Abd-El-Rhman-Saad/solar-ev-charging-station-bess/Docs/LaTeX_Source/cover.tex

\begin{titlepage}
\thispagestyle{empty}

\begin{center}
\vspace*{1.5cm}
% Logo
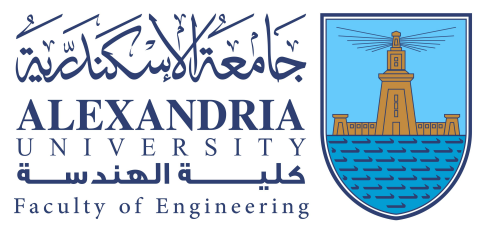
[picture p79: Docs/LaTeX_Source/Figures/logo.png]
 % غيري الاسم حسب اسم ملف اللوجو

\vspace{0.4cm}

{\small Electrical Power and Machines Department}

\vspace{0.5cm}

{\huge\bfseries Integration of Photovoltaic Systems and Energy Storage for Electric Vehicle Charging Station}

\vspace{0.3cm}

{\normalsize B.Sc. Graduation Project 2026}

\vspace{1.5cm}

{\large\textbf{Prepared by:}}

\vspace{0.3cm}

\begin{center}

\large

\renewcommand{\arraystretch}{1.4}

\begin{tabular}{c @{\hspace{2cm}} c}

\multicolumn{2}{c}{Nour El-Deen Mohamed Fathy} \\

\multicolumn{2}{c}{Abd El-Rahman Muhammad Saad} \\

\multicolumn{2}{c}{Hassan Ibrahim Hassan Al Halwani} \\

\multicolumn{2}{c}{Mai Nagah Ali} \\

\multicolumn{2}{c}{Mariam Mamdouh Ibrahim} \\

\multicolumn{2}{c}{Rewan Amr Mahmoud} \\

\multicolumn{2}{c}{Rwan Mohamed Abd-Elmokhtar} \\

\multicolumn{2}{c}{Yasmeen Salah Khobeez} \\

\multicolumn{2}{c}{Youssef Ebrahim Abd El-Sattar} \\

\end{tabular}

\end{center}

\vfill
{\Large Prof. Dr. Ahmed Abbas El Serougi}

\end{center}

\end{titlepage}
