Abd-El-Rhman-Saad/solar-ev-charging-station-bess/Docs/LaTeX_Source/List of Abbreviations.tex

\renewcommand{\arraystretch}{1.2}

\begin{longtable}{p{3cm}p{11cm}}

\textbf{Abbreviation} & \textbf{Definition} \\ \hline
\endfirsthead

\textbf{Abbreviation} & \textbf{Definition} \\ \hline
\endhead
CO2  & Carbon Dioxide \\
PV   & Photovoltaic \\
BOS  & Balance of System \\
STC  & Standard Test Conditions \\
DC   & Direct Current \\
AC   & Alternating Current \\
MPPT & Maximum Power Point Tracking \\
BESS  & Battery Energy Storage System \\
BMS  & Battery Management System \\
NiMH  & Nickel-Metal Hydride \\
Li-ion & Lithium-ion \\
EV   & Electric Vehicle \\
P\&O  & Perturb and Observe  \\
GMPPT & Global Maximum Power Point Tracking  \\
OBC  & On-Board Charger \\
PWM  & Pulse Width Modulation \\
SOC  & State of Charge \\
SPWM & Sinusoidal Pulse Width Modulation \\
THD  & Total Harmonic Distortion \\
Ir   & solar irradiance  \\
IBC  & Interleaved Boost Converter  \\
V2G  & Vehicle-to-Grid  \\
PI   & Proportional-Integral  \\
PLL  & Phase Locked Loop  \\
VSC  & Voltage Source Converter  \\
Id   & Direct current  \\
Iq   & Quadrature current  \\
BW   & BandWidth  \\
Ma   & Modulation Index  \\
CC   & Constant Current  \\
CV   & Constant Voltage  \\
PI   & Proportional-Integral  \\
PLL  & Phase Locked Loop  \\
VSC  & Voltage Source Converter  \\
Voc  & Open-Circuit Voltage  \\
Vmpp  & Voltage at Maximum Power  \\
Isc  & Short-Circuit Current  \\
Impp  & Current at Maximum Power \\
ESS  & Energy Storage System  \\
%last chapter 
DAB  & Dual Active Bridge  \\
ZVS  & Zero Voltage Switching  \\
WBG  & Wide-bandgap  \\
Si  & Silicon  \\
SiC  & Silicon Carbide  \\
GaN  & Gallium Nitride  \\
VB  & Valence Band  \\
CB  & Conduction Band  \\
AI  & Artificial Intelligence  \\
FLC  & Fuzzy Logic Control  \\
ANNs  & Artificial Neural Networks  \\
RL  & Reinforcement Learning  \\
EMS  & Energy Management System  \\
IoT  & Internet of Things  \\
ESS & Energy storage system \\
D & duty cycle  \\
$f_{s}$  & switching frequency  \\
$\Delta i_{l}$ & current ripples \\
% --- Added from Hardware Implementation (Section 6.2) ---
CCM & Continuous Conduction Mode \\
ESR & Equivalent Series Resistance \\
MCU & Microcontroller Unit \\
ADC & Analog-to-Digital Converter \\
ISR & Interrupt Service Routine \\
DSO & Digital Storage Oscilloscope \\
$R_{DS(on)}$ & On-State Drain-to-Source Resistance \\
$V_{DS}$ & Drain-to-Source Breakdown Voltage \\
$C_{iss}$ & Input Capacitance \\
$Q_{gd}$ & Gate-to-Drain Miller Charge \\
$T_J$ & Junction Temperature \\
$T_C$ & Case Temperature \\
CTR & Current Transfer Ratio \\
OVP & Over-Voltage Protection \\
UVP & Under-Voltage Protection \\
OCP & Over-Current Protection \\
UVLO & Under-Voltage Lockout \\
SGND & Signal Ground \\
PGND & Power Ground \\
\end{longtable}
