Abd-El-Rhman-Saad/solar-ev-charging-station-bess/Docs/LaTeX_Source/references.tex

\renewcommand{\bibname}{References}

\begin{thebibliography}{99}

\bibitem{masters2013}
G. M. Masters,
\textit{Renewable and Efficient Electric Power Systems},
2nd ed., John Wiley \& Sons, 2013.

\bibitem{dunn2011}
B. Dunn, H. Kamath, and J. M. Tarascon,
"Electrical Energy Storage for the Grid: A Battery of Choices,"
\textit{Science},
vol. 334, no. 6058, pp. 928--935, 2011.

\bibitem{tie2013}
S. F. Tie and C. W. Tan,
"A Review of Energy Sources and Energy Management System in Electric Vehicles,"
\textit{Renewable and Sustainable Energy Reviews},
vol. 20, pp. 82--102, 2013.

\bibitem{mohan2003} N. Mohan, T. M. Undeland, and W. P. Robbins, \textit{Power Electronics: Converters, Applications, and Design}, 3rd ed., John Wiley \& Sons, 2003.

\bibitem{singh2020} A. K. Singh, et al., ``Solar PV and Grid Based Isolated AC/DC Microgrid for Electric Vehicle Charging Station,'' \textit{IEEE Transactions on Industry Applications}, 2020.

\bibitem{emadi2015}
A. Emadi,
\textit{Advanced Electric Drive Vehicles},
CRC Press, 2015.

\bibitem{iea2024}
International Energy Agency (IEA),
\textit{Global EV Outlook 2024},
Paris, France, 2024.

\bibitem{baliga2008}
B. J. Baliga,
\textit{Fundamentals of Power Semiconductor Devices},
Springer, 2008.

\bibitem{wolfspeed}
Wolfspeed,
\textit{Silicon Carbide Technology Overview},
Technical Report.

\bibitem{rehmani2018}
M. H. Rehmani, M. Reisslein, A. Rachedi, M. Erol-Kantarci, and M. Radenkovic,
"Integrating Renewable Energy Resources into the Smart Grid: Recent Developments in Information and Communication Technologies,"
\textit{IEEE Transactions on Industrial Informatics},
2018.

\bibitem{faraj2020}
Faraj, K. S., \& Farhood, J. (2020). Analysis and Comparison of DC-DC Boost Converter and Interleaved DC-DC Boost Converter. \textit{International Journal of Engineering and Technology}, 622--635.

\end{thebibliography}
