Abd-El-Rhman-Saad/solar-ev-charging-station-bess/1_PV_Modeling_and_MPPT/images/forced_mppt_logic2.png

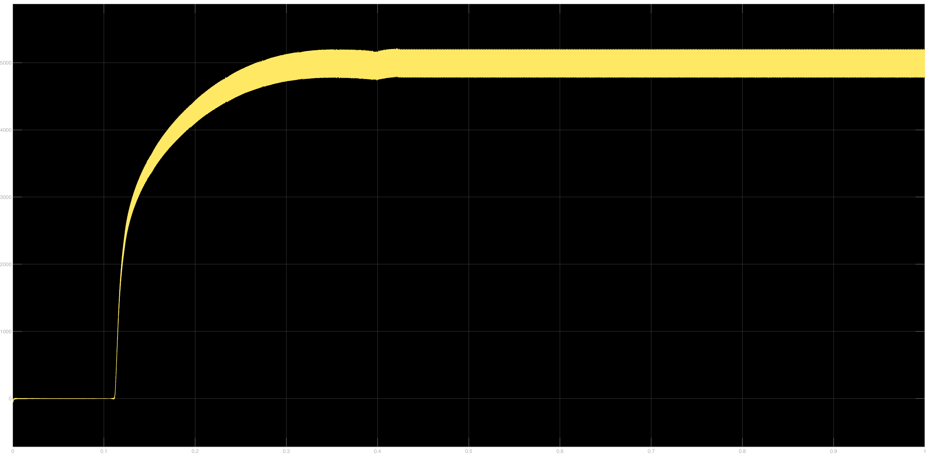
1_PV_Modeling_and_MPPT/images/forced_mppt_logic2.png
