Abd-El-Rhman-Saad/solar-ev-charging-station-bess/1_PV_Modeling_and_MPPT/images/mppt_logic.png

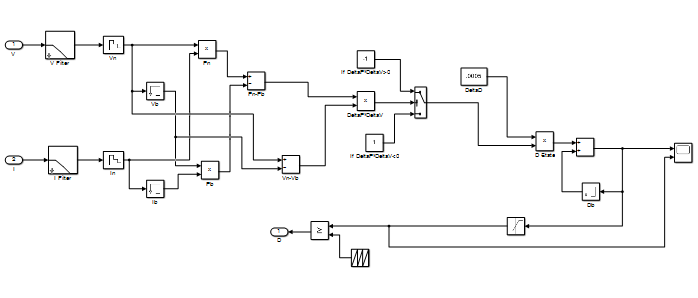
1_PV_Modeling_and_MPPT/images/mppt_logic.png
