Abd-El-Rhman-Saad/solar-ev-charging-station-bess/2_Interleaved_Boost_Converter/images/interleaved_system_model.png

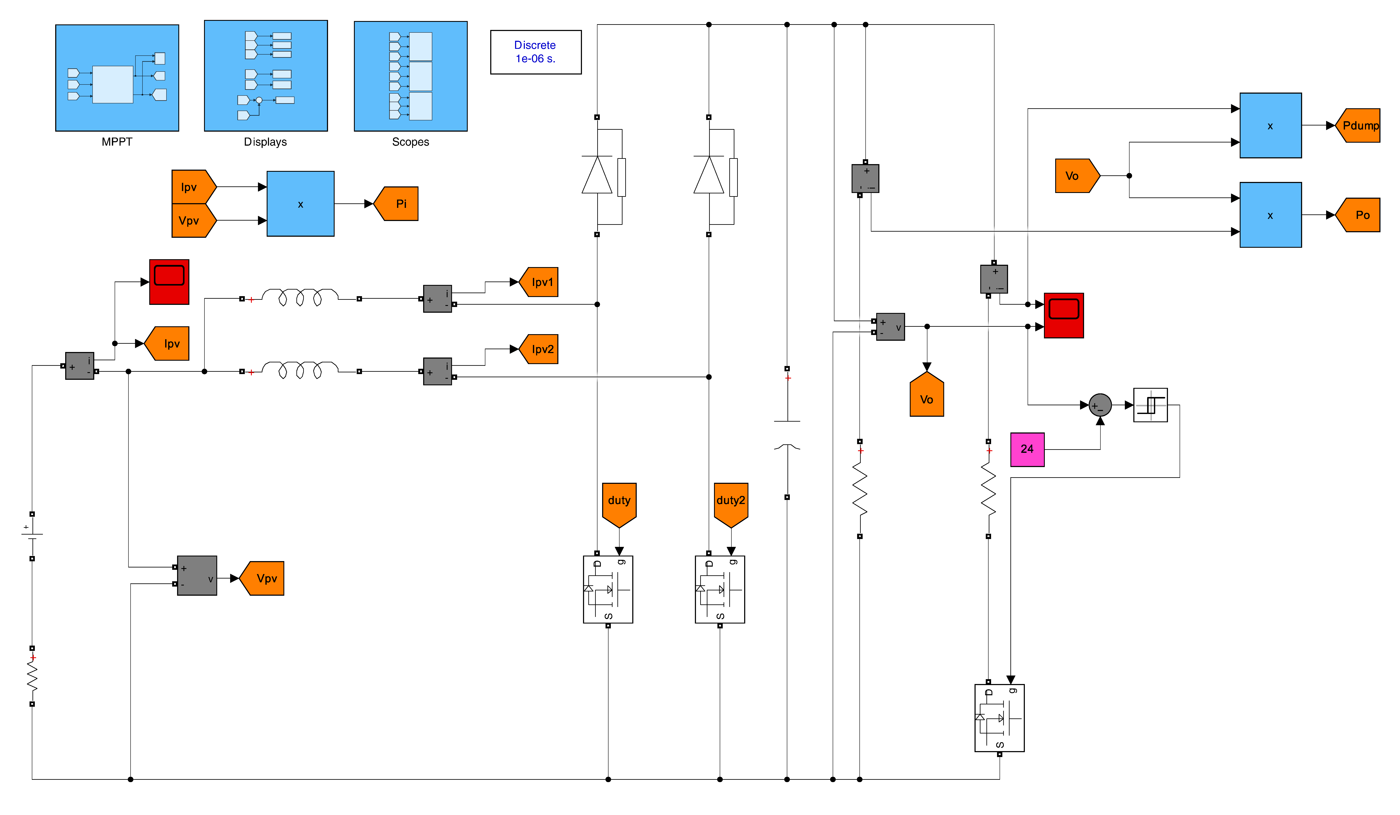
2_Interleaved_Boost_Converter/images/interleaved_system_model.png
