Abd-El-Rhman-Saad/solar-ev-charging-station-bess/2_Interleaved_Boost_Converter/images/ripple_cancellation.png

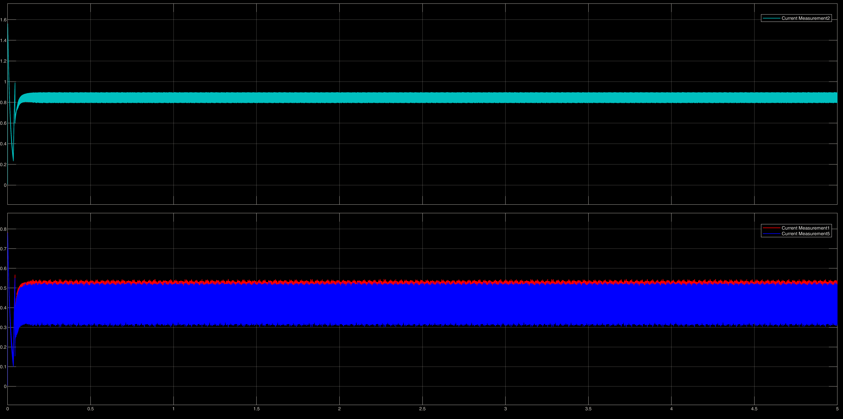
2_Interleaved_Boost_Converter/images/ripple_cancellation.png
