Abd-El-Rhman-Saad/solar-ev-charging-station-bess/3_BESS_and_2Q_Chopper/images/2q_chopper_model.png

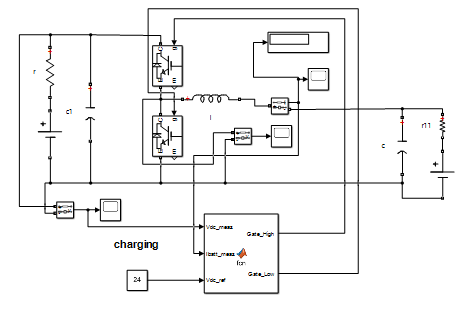
3_BESS_and_2Q_Chopper/images/2q_chopper_model.png
