Abd-El-Rhman-Saad/solar-ev-charging-station-bess/3_BESS_and_2Q_Chopper/images/chopper_control_code.png

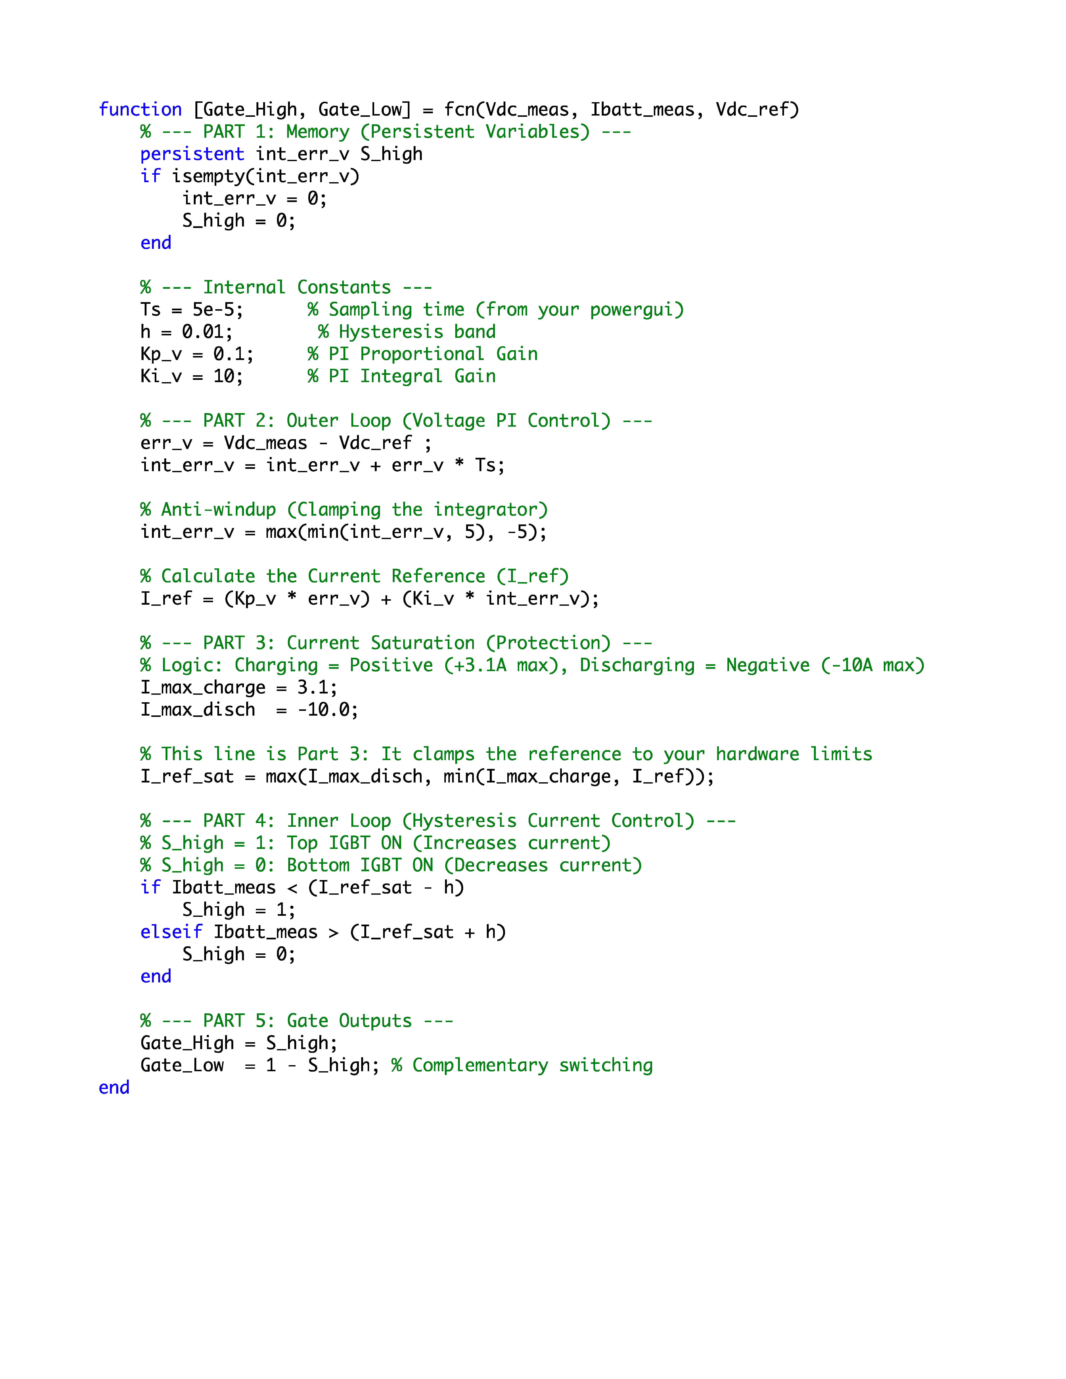
3_BESS_and_2Q_Chopper/images/chopper_control_code.png
