Abd-El-Rhman-Saad/solar-ev-charging-station-bess/4_EV_Buck_Charger/images/Buck_CCCV_Scope_2.png

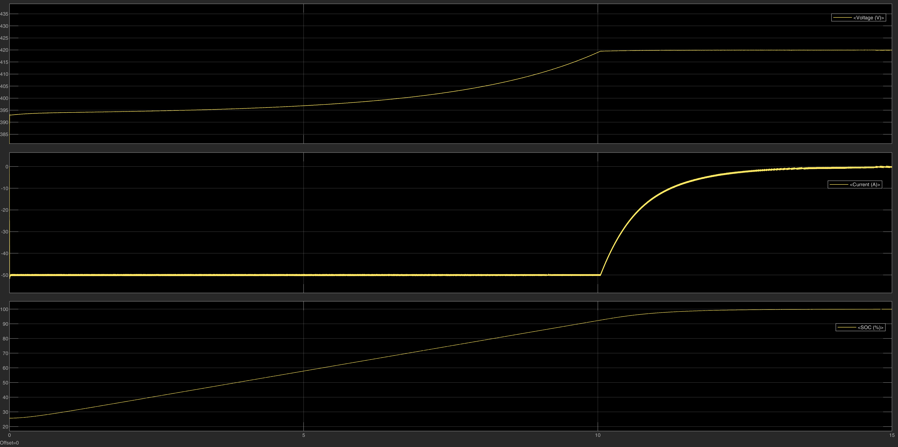
4_EV_Buck_Charger/images/Buck_CCCV_Scope_2.png
