Abd-El-Rhman-Saad/solar-ev-charging-station-bess/4_EV_Buck_Charger/images/PWM_Generator_Zoomed.jpg

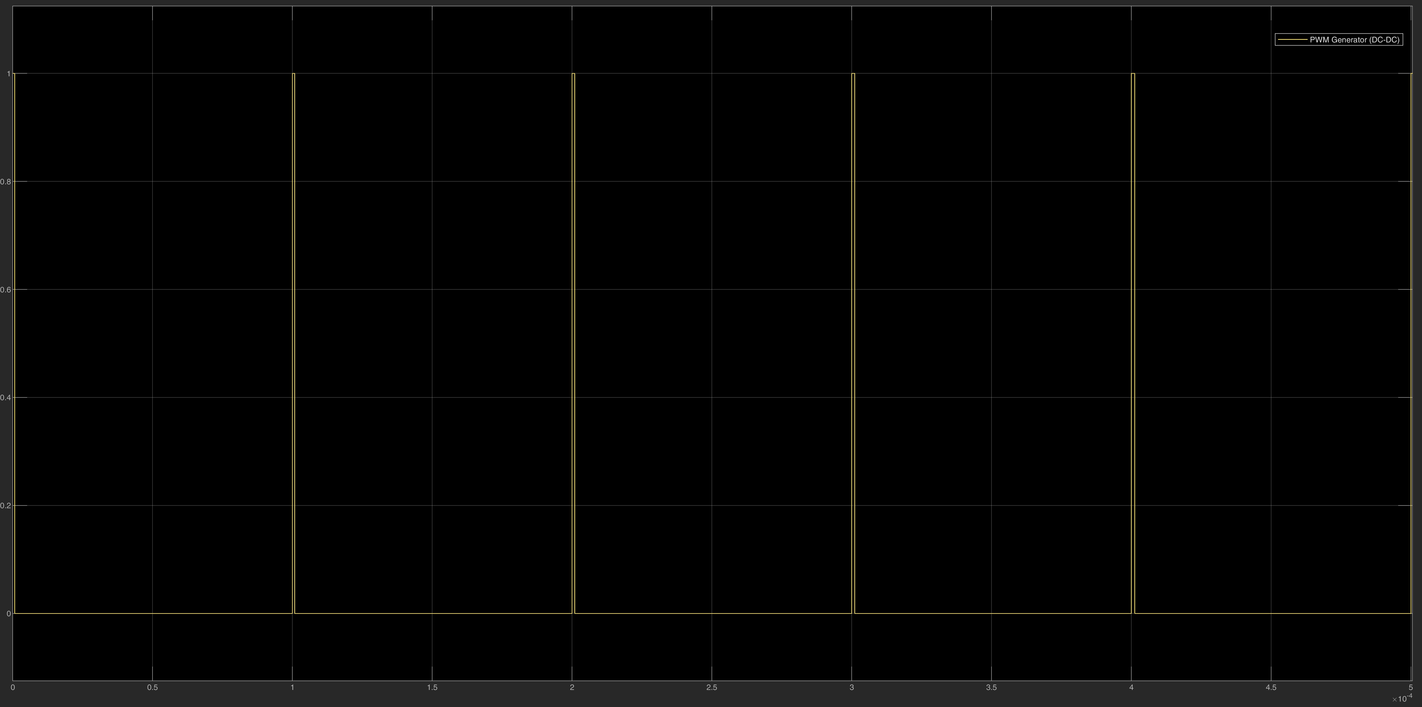
4_EV_Buck_Charger/images/PWM_Generator_Zoomed.jpg
