Abd-El-Rhman-Saad/solar-ev-charging-station-bess/Docs/LaTeX_Source/Figures/1.systeam software.jpeg

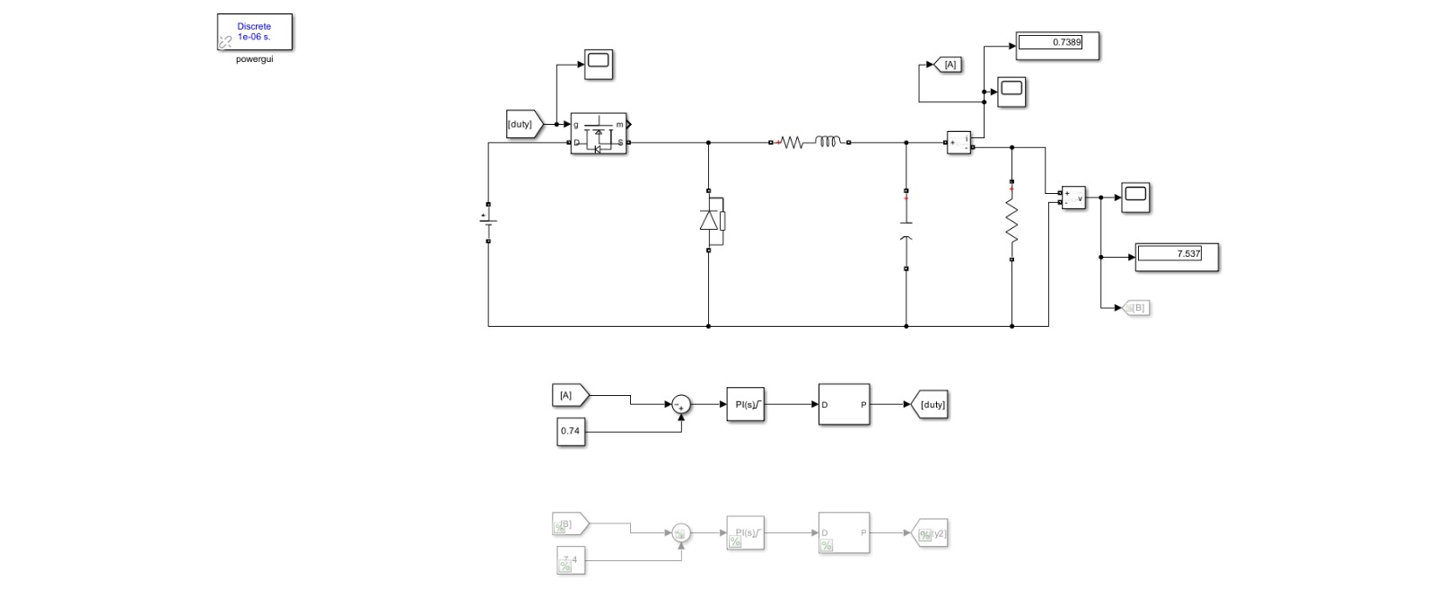
Docs/LaTeX_Source/Figures/1.systeam software.jpeg
