Abd-El-Rhman-Saad/solar-ev-charging-station-bess/Docs/LaTeX_Source/Figures/2.image.jpg

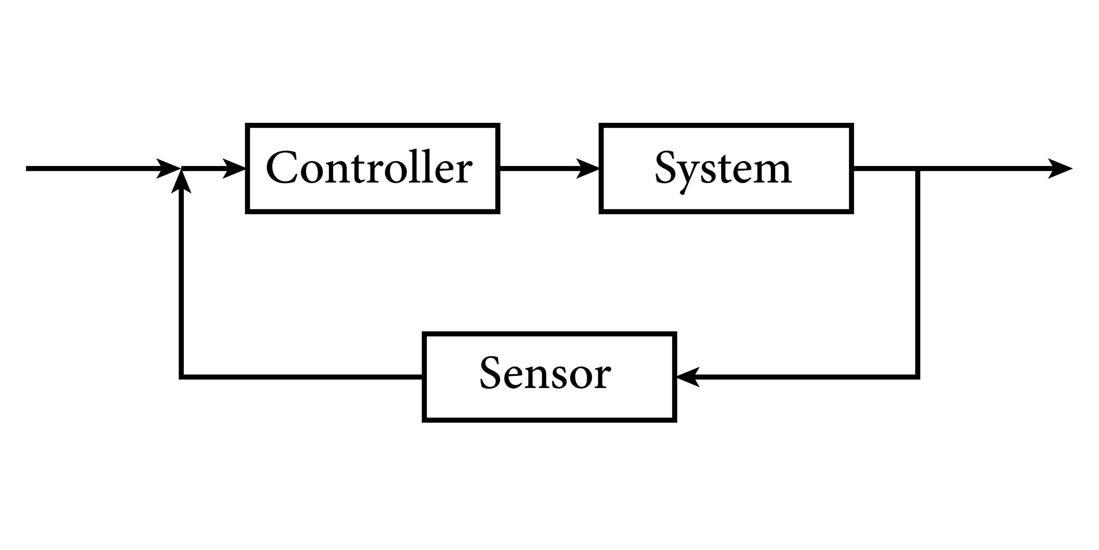
Docs/LaTeX_Source/Figures/2.image.jpg
