Abd-El-Rhman-Saad/solar-ev-charging-station-bess/Docs/LaTeX_Source/Figures/3.pid.png

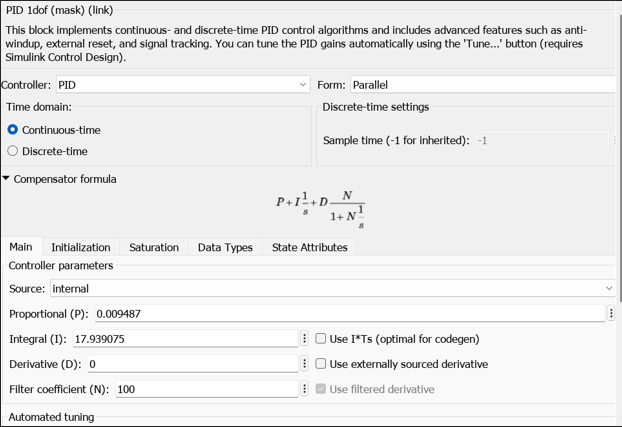
Docs/LaTeX_Source/Figures/3.pid.png
