Abd-El-Rhman-Saad/solar-ev-charging-station-bess/Docs/LaTeX_Source/Figures/4.0.5a OPEN LOOP.png

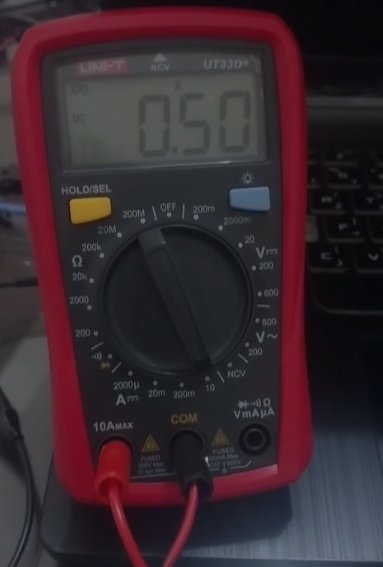
Docs/LaTeX_Source/Figures/4.0.5a OPEN LOOP.png
