Abd-El-Rhman-Saad/solar-ev-charging-station-bess/Docs/LaTeX_Source/Figures/5.Iref1=0.3A.jpeg

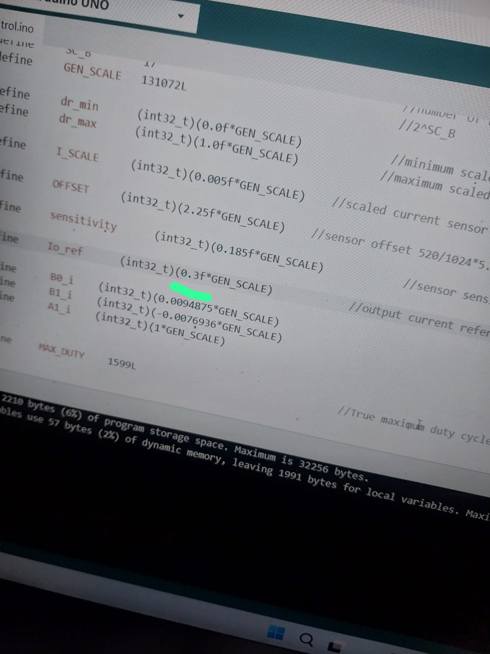
Docs/LaTeX_Source/Figures/5.Iref1=0.3A.jpeg
