Abd-El-Rhman-Saad/solar-ev-charging-station-bess/Docs/LaTeX_Source/Figures/6.3.6 3.7V.jpeg

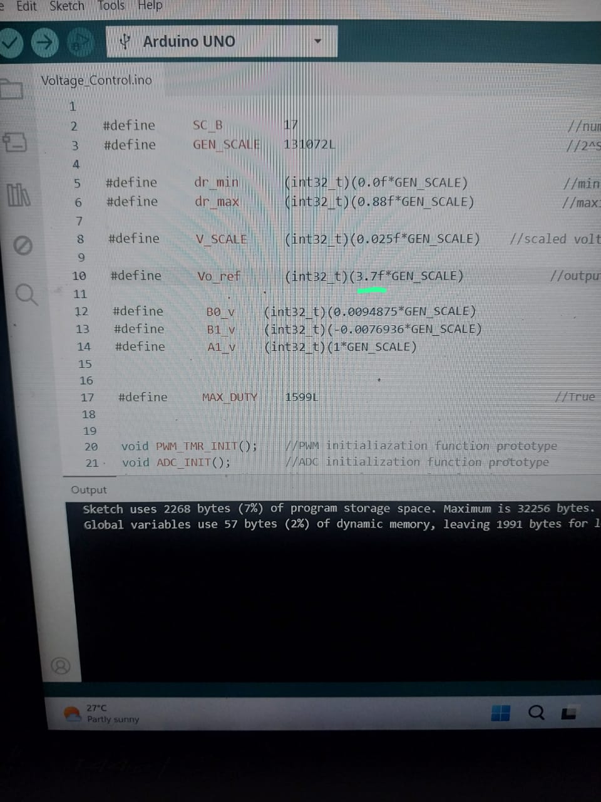
Docs/LaTeX_Source/Figures/6.3.6 3.7V.jpeg
