Abd-El-Rhman-Saad/solar-ev-charging-station-bess/Docs/LaTeX_Source/Figures/6.Iref2= 0.5A.jpeg

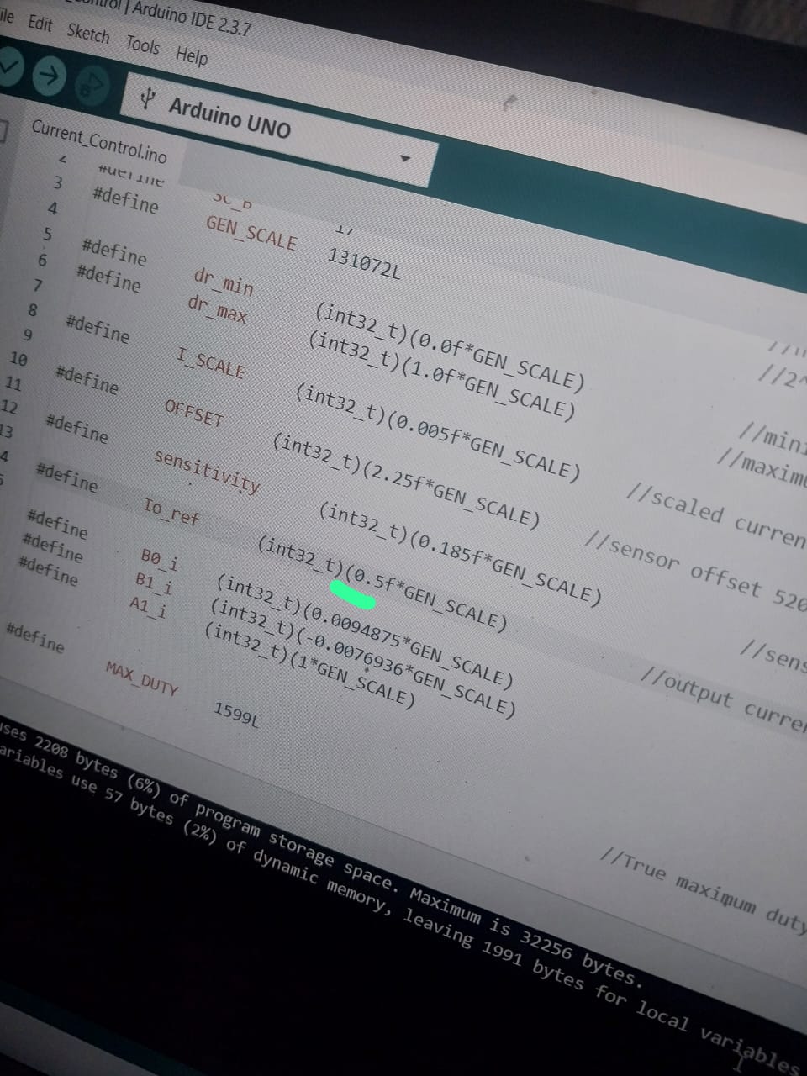
Docs/LaTeX_Source/Figures/6.Iref2= 0.5A.jpeg
