Abd-El-Rhman-Saad/solar-ev-charging-station-bess/Docs/LaTeX_Source/Figures/7.Iref3 = 0.4A.jpeg

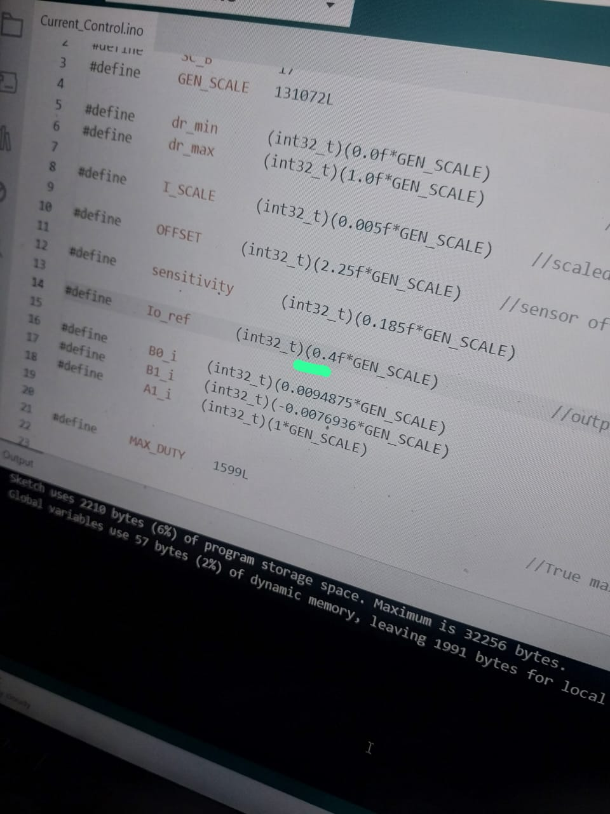
Docs/LaTeX_Source/Figures/7.Iref3 = 0.4A.jpeg
