Abd-El-Rhman-Saad/solar-ev-charging-station-bess/Docs/LaTeX_Source/Figures/8.Iref= 0.6A.jpeg

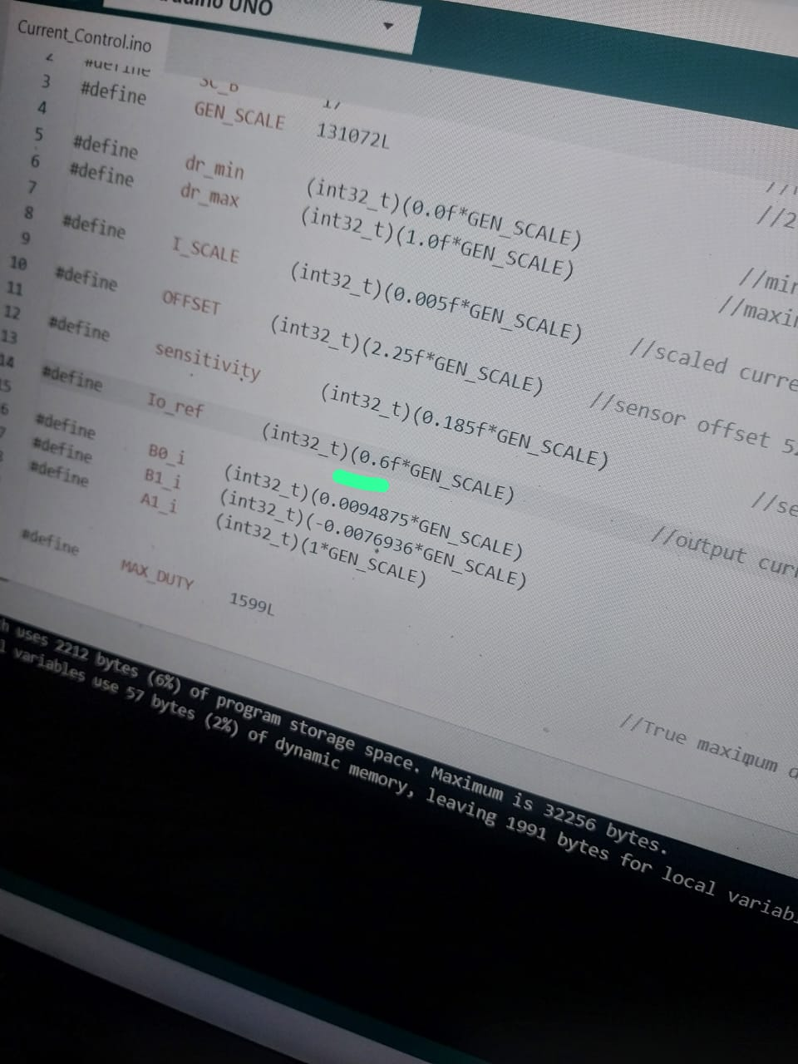
Docs/LaTeX_Source/Figures/8.Iref= 0.6A.jpeg
