Abd-El-Rhman-Saad/solar-ev-charging-station-bess/Docs/LaTeX_Source/Figures/11.reading 0.5A.png

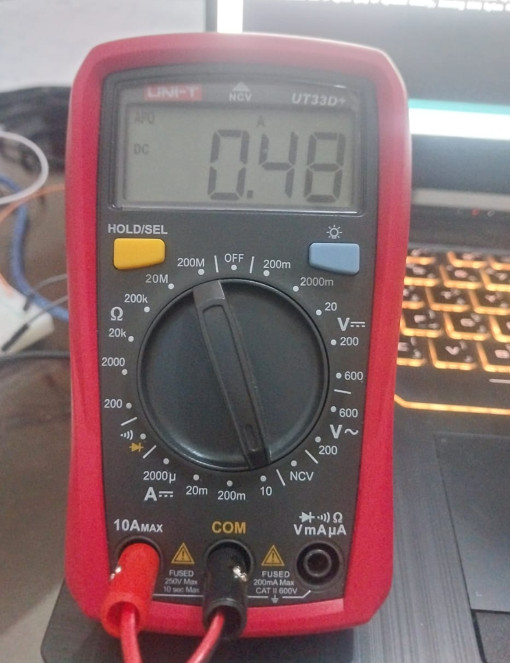
Docs/LaTeX_Source/Figures/11.reading 0.5A.png
