Abd-El-Rhman-Saad/solar-ev-charging-station-bess/Docs/LaTeX_Source/Figures/Figure 1.21.png

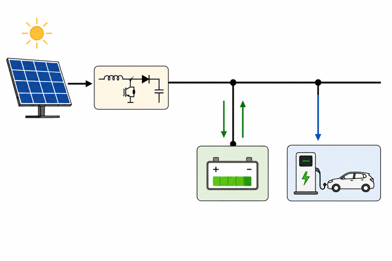
Docs/LaTeX_Source/Figures/Figure 1.21.png
