Abd-El-Rhman-Saad/solar-ev-charging-station-bess/Docs/LaTeX_Source/Figures/Figure 2.19.png

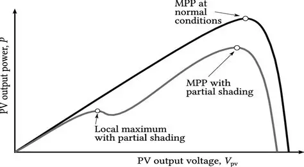
Docs/LaTeX_Source/Figures/Figure 2.19.png
