Abd-El-Rhman-Saad/solar-ev-charging-station-bess/Docs/LaTeX_Source/Figures/scopes2.jpg

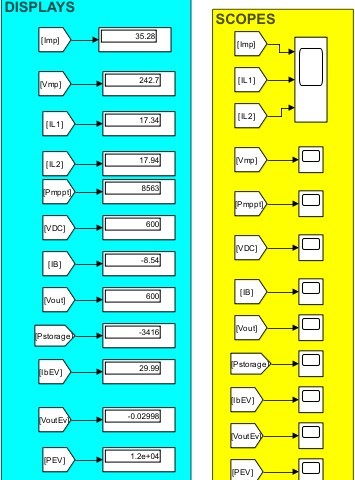
Docs/LaTeX_Source/Figures/scopes2.jpg
