Abd-El-Rhman-Saad/solar-ev-charging-station-bess/(commit log)

2026-10-08 Add interleaved boost converter models
    Adds a three-phase design path for the PV-to-DC-link boost stage: open-loop single- and two-phase boost models, Thevenin-based tuning models, and the final closed-loop interleaved converter. Includes README documentation and result plots showing ripple cancellation and output regulation.
2026-10-08 Add BESS two-quadrant chopper models
    This commit adds the BESS and two-quadrant chopper simulation set, including open-loop prototype and actual-rating models, closed-loop scenario models, and supporting documentation. It also includes the model images and a README explaining the system overview, control strategy, and how to run the simulations.
2026-10-08 Add EV buck charger Simulink model and assets
    Adds an open-loop Simulink buck converter model (4_EV_Buck_Charger/Buck.slx) plus README and example output images. The model demonstrates stepping a 600 V DC link down to an EV battery and inspects switching ripple and power. README documents the CC‑CV charging strategy, open‑loop results, and run instructions; closed‑loop CC‑CV models are noted but not included.
2026-10-08 Add hardware PCB design archives and README
    Create 5_Hardware_and_PCB_Design with three Altium archives (Interleaved_Thevenin.zip, Buck_Converter.zip, Two_Quadrant_Chopper.rar) and a README. The README documents the included boards, how to open the Altium projects, key prototype components (MOSFETs, optocoupler, IR2111, Arduino controller), measurement setup, and PCB layout practices.
2026-10-08 Add LaTeX thesis source for PV EV station
    This commit adds the complete LaTeX report source for the solar PV and EV charging station project. It includes the cover page, abbreviations, bibliography, chapter structure, and detailed sections covering renewable energy, MPPT, DC-DC converters, simulation results, hardware implementation, and future improvements.
2026-10-08 Add LaTeX figure assets
    This change adds the image and figure assets used throughout the LaTeX documentation, including system diagrams, PCB layouts, battery charging profiles, hardware waveforms, and experimental result images for the project report.
2026-10-08 Expand project README and architecture docs
    This commit replaces the minimal repository intro with a full project overview for the solar EV charging station. It adds the executive summary, power-flow architecture, hardware and rating tables, module descriptions for PV, boost, BESS, and buck stages, documentation links, usage guidance, and team/supervision details.
2026-10-09 Rename PCB archive to ZIP format
    Renamed the Two Quadrant Chopper hardware archive from .rar to .zip to match the repository's expected distribution format. This is a file-format rename only; the underlying asset content remains the same.
2026-10-09 Add controlled buck charger model
    This commit adds a new controlled buck charger Simulink model and supporting images. It includes the full system layout, control loop view, and detailed PWM/current/voltage measurement diagrams to document the charger design and operation.
2026-10-09 Document buck converter models and control
    Expanded the EV buck charger README to describe both the 600 V open-loop power-stage model and the prototype-scale closed-loop PI current-controlled model. It clarifies the CC-CV charging strategy, adds the key model parameters and simulation results, and updates the run instructions for the included Simulink files.
2026-10-09 Document EV buck charger control model
    Updated the README to clarify the EV buck charger modeling and control status. It now distinguishes the open-loop sizing model for the 600 V DC link, the prototype closed-loop buck controller with PI CC/CV logic, and the thesis-documented full CC-CV supervision and hardware validation.
2026-10-10 Update team member count in README
    Adjust the team section in the README to reflect the current team size. This change updates the count from nine to eight students and keeps the project documentation accurate.
2026-10-30 Update PV directory with P&O flowchart, embedded C firmware, and STC specs
    - Added P&O decision flowchart (po_flowchart.png) to images/ directory.
    - Added embedded C firmware source code (mppt_po.c) for microcontroller execution.
    - Updated README.md with official Single-Diode STC parameter specifications (Voc=229.4V, Pmax=192.5W, Rs=0.145 ohm).
    - Clarified design progression from baseline P&O to advanced Global Scanning MPPT.
2026-10-30 Update Interleaved Boost README with 8.5kW sizing and ripple equations
    - Added full-scale PV station sizing specifications (8.5 kW, 12 modules @ 710W, 600V DC bus) based on Section 5.1 of the thesis.
    - Documented closed-form mathematical ripple cancellation formulas for the 2-phase 180-degree interleaved topology.
    - Included architectural comparison between Centralized and String-level converter topologies.
    - Retained all 5 progressive Simulink models and verified simulation scope assets.
2026-10-30 Update 2Q Chopper README with Bilinear discretization and BESS sizing
    - Added mathematical derivations for Buck (charging) and Boost (discharging) operational regimes.
    - Documented digital control discretization via Bilinear (Tustin) Z-transform and fixed-point difference equations for microcontroller firmware.
    - Added comparative engineering parameters table (600V/3.48kW full-scale BESS vs 2S Li-ion laboratory prototype).
    - Ensured all image references strictly follow Markdown [images/name.png] syntax.
2026-10-30 Update Interleaved Boost README with 8.5kW sizing and ripple equations
    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
2026-10-30 Render converter README equations inline
    Replace the two display-math blocks for PV power and module count with inline equations.
2026-10-31 Complete EV Buck Charger with CC/CV model, Section 6.3 derivations, and full scope suite
    - Added Buck_Closed_Loop_CCCV_Charger.slx demonstrating autonomous CC-to-CV transition at t = 6.2s.
    - Linked all 14 schematic and scope image assets including annotated and raw CC/CV waveforms.
    - Documented Section 6.3 thesis derivations: non-ideal duty cycle (Du = 39.75%), parasitic component sizing, and controller gains.
    - Verified 100% adherence to Style 3 Markdown formatting and LaTeX display math.
2026-10-31 docs(hardware): complete comprehensive PCB design, BOM, and laboratory validation README
    Add rigorous hardware documentation for 5_Hardware_and_PCB_Design covering Altium EDA architecture, layout rules, full BOM from thesis Chapter 3, 10 kHz Phase-Correct PWM embedded C firmware, and experimental oscilloscope and multimeter current tracking results across 0.3A-0.6A setpoints.
2026-11-01 docs(interleaved-boost): curate 300dpi ripple cancellation assets and update comprehensive README
    Upgrade 2_Interleaved_Boost_Converter with 300 DPI power stage schematics, physical ripple cancellation waveforms, closed-loop current-sharing scopes, and clean directory structure.
2026-11-01 Upgrade 2_Interleaved_Boost_Converter with 300 DPI power stage schematics, physical ripple cancellation waveforms, closed-loop current-sharing scopes, and clean directory structure.
    docs(interleaved-boost): curate 300dpi ripple cancellation assets and update comprehensive README
2026-11-01 docs(bess-2q): curate 300dpi multi-case benchmark assets and update master BESS technical README
    Comprehensive upgrade of 3_BESS_and_2Q_Chopper including 300 DPI multi-case benchmark schematics, mathematical Z-domain difference equations, full embedded MATLAB Function source code, dynamic transient scopes, and clean directory structure.
2026-11-02 docs(ev-charger): add rigorous CC/CV derivations, parasitic modeling, and 300 DPI figures
    Add complete analytical derivations for non-ideal Buck duty cycle compensation, component sizing margin analysis, supervisory CC-to-CV mode transition logic, and integrate 8 curated 300 DPI Simulink architecture schematics and transient scope waveforms.
2026-11-02 docs(hardware): unify README to Style 3 centered HTML images and KaTeX formatting
    Standardize image presentation across hardware prototyping documentation using centered HTML tags, update multi-setpoint multimeter gallery layout, and ensure clean ASCII math rendering for embedded timer equations.
2026-11-02 docs(integration): add full microgrid EMS power balance and 300 DPI scope verification
    Add rigorous hierarchical control documentation, numerical EMS power balance proofs, cascade PI DC-bus regulation analysis, and embed 16 high-resolution 300 DPI architecture schematics and dynamic scope waveforms.
2026-11-02 docs(root): publish master project README with verified specs, hardware leadership, and module matrix
    Publish comprehensive master documentation establishing microgrid 600V DC-link architecture, multi-converter power balancing proofs, interactive navigation matrix across all 6 sub-modules, laboratory experimental validation highlights, and formal academic acknowledgments.
2026-11-02 docs(integration): expand telemetry gallery to encompass all 28 high-res 300 DPI assets
    Incorporate supplementary zoomed ripple analyses, raw chopped rail waveforms, sub-microsecond MPPT carrier dynamics, and document all 28 high-resolution simulation assets within the integration report.
2026-11-02 Clarify global MPPT trigger notation
    Express the persistent power-drop threshold relative to previous power and correct the scan-minimum subscript notation.
2026-11-02 Remove math formatting from ripple percentages
    Use plain text for the 60% current ripple and 2% voltage ripple targets in the component sizing documentation.
2026-11-02 Correct current-step verification results
    Update the current-step response table to match the multimeter readings and thesis results, including corrected tracking errors and removal of timer register values.
2026-11-02 Clarify system capability and voltage overshoot
    Label nighttime operation as a design capability and revise the DC-link overshoot bound to match the stated 603.8 V peak.
2026-11-02 docs(bess): expand engineering documentation and practical solutions
    Add subsystem lead details and practical design challenges covering gate isolation, anti-windup, hysteresis tuning, Tustin discretization, and battery current limits. Refine operational descriptions and model documentation.
2026-11-02 docs: standardize author header and core focus across all converter modules
    Unify author metadata to Project Engineer across all submodules (PV Modeling, Interleaved Boost, BESS Chopper, and EV Buck) with explicit per-module technical focus tags.
2026-11-02 docs(buck): add parasitic compensation derivation, CC-CV logic, and fix KaTeX formatting
    Detail hardware bench parasitics, volt-second non-ideal duty cycle derivation, and automated CC/CV state machine transitions. Resolve markdown-KaTeX delimiter collision on duty cycle notes and align all 8 images to Style 3.
2026-11-02 docs(hardware): add Altium EDA workflow, BOM, Timer 1 firmware, and bench multimeter validation.
    Document high-power PCB layout guidelines, complete bill of materials, ATmega328P 10 kHz Phase-Correct PWM firmware, and empirical multimeter tracking accuracy bounded within 5.0% error (thesis Table 6.1). Standardize author header and center all 12 experimental assets.
2026-11-02 docs(microgrid): document full closed-loop system integration, EMS balance, and 28 telemetry assets
    Add comprehensive microgrid architecture documentation, steady-state display table (8.5 kW PV, 600 V bus, 4.1 kW EV load, 4.5 kW BESS), and instantaneous EMS power conservation equations. Align all 28 level-1/2 schematics and zoom scopes to Style 3.
2026-11-02 docs: finalize master README with expanded EMS matrix, R2024b, and KaTeX fixes
    Expand EMS operational regimes with KCL bus dynamics and 4-state power flow table. Update MATLAB toolchain version to R2024b, update official contact email, and resolve KaTeX formatting syntax on Timer 1 TOP register and dissipation terms.
2026-11-03 Refactor root and module READMEs to reconcile technical review and bench telemetry
    - Correct power balance explanation to attribute the 0.9% residual to discrete oscilloscope capture timing before dynamic bus settling, citing the thesis steady-state balance (~8.52 kW = 4.0 kW + 4.52 kW).
    - Align current tracking documentation by combining thesis Table 6.1 (0.20 A baseline) with bench multimeter photos (0.30 A - 0.60 A), bounding worst-case tracking error at -5.0% and removing ungrounded thermal/drift claims.
    - Correct Simulink model references in the Repository Tour table to Interleaved_Boost_Thevenin_Equivalent.slx, Interleaved_Boost_Thevenin_Full_Control_ForDesign.slx, and Interleaved_Boos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
2026-11-03 Refine technical assertions across root README per senior reviewer feedback
    - Replace bumpless transfer claim in EV charger row with automatic CC-CV transition.
    - Align Challenge 3 with thesis design frequency (10 kHz) and observed bench audible whine cessation.
    - Clarify dynamic OCR1A constrain limits as effective 6%-94% duty bounds.
    - Rephrase power balance scope snapshot to reflect capture timing before complete bus settling and remove trailing formatting artifacts.
    - Refactor ground bounce challenge as proactive Star Grounding design architecture.
2026-11-04 Refactor BESS module challenges to replace synthetic validation with design notes
    - Replace ungrounded validation bullets in Module 3 with precise Design Notes.
    - Remove fictitious 20 kHz ISR and 12 us execution time claims; document MCU loop rate (~200 Hz).
    - Explicitly differentiate between Simulink hysteresis modeling (h = 0.01 A) and the physical 10 kHz PI-PWM bench prototype.
    - Ground anti-windup clamping to [-5, +5] and simulation overshoot to 603.8 V (~0.63%).
    - Reframe battery current saturation limits as model boundaries, citing HW-391 BMS for physical pack protection.
2026-11-04 Align subsystem READMEs with thesis models, curve telemetry, and bench firmware roles
    - Correct Module 1 PV table to reflect single-module parameters (95 W, 18.7 V, 22.94 V Voc at 318 K) matching pv_curves.slx and plots.
    - Reconcile Module 6 power balance with root README and update operating point and current-sharing split wording.
    - Clarify Module 3 Tustin derivation as MCU formulation (thesis 4.1.2.6) vs forward-Euler simulation model, and correct Quadrant I / IV conventions.
    - Document dual firmware roles in Module 5 (bench telemetry sketch at ~200 Hz vs thesis Listing 6.3 10 kHz fixed-point ISR) and correct Euler integration comment.
    - Soften descriptive superlatives and replace 'provin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
2026-11-04 Refactor individual contributions, rework notes, and module claims per reviewer pack
    - Root README: Update Individual Contribution to accurately reflect hardware design, review, manual rework, and firmware debugging roles; remove ungrounded firmware authorship claims.
    - Module 5: Add Interleaved Boost manual fabrication rework section and pre-rework archive note; update firmware versions to neutral thesis vs telemetry description.
    - All Modules: Unify header metadata to acknowledge the 8-member team project with documentation credit.
    - Module 6: Rephrase line 33 to balanced power split and remove (STC) label from ASCII block.
    - Module 1: Rephrase Global MPPT settling to ~5.0 kW mean with 4.8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
2026-11-05 Finalize hardware BOM, E-core magnetic ratings, and firmware directory structure
    - Module 5: Correct BOM (C2 to 10 uF, ceramic C1/C4, add C5/C6/R1/R2/diodes/terminals), update archive table, refine replication steps, and add TDK-Lambda GEN300-11 and UT89X meters.
    - Module 5 & Root: Classify inductor as 2.0 mH E-core ferrite choke per Altium library and board photo.
    - Root README: Relocate contact badges to top of document and refine Challenge 2 & 3 hardware-only context.
    - Module 1: Classify mppt_po.c as floating-point ANSI C and align Global MPPT scope text with 5.09 kW mean operating point.
    - Root Repo: Add Firmware/ directory containing verbatim thesis listings (6.1, 6.2, 6.3), MATLAB fun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
2026-11-05 Fully synchronize Module 5 hardware BOM, OutJob workflow, and E-core inductor ratings
    - Module 5 BOM: Correct C2 to 10 uF radial electrolytic, C1/C4 to ceramic disc, add C5 (100 nF), C6 (1 nF), R1 (1 k), R2 (330), and J1-J5 terminal blocks.
    - Hardware Archive & CAM: Update Two_Quadrant_Chopper.zip to reflect .SchDoc, .PcbDoc, 2Q_Final.OutJob, CAM docs, and libraries; align replication steps with OutJob generation.
    - Equipment Table: Update multimeters to UNI-T UT33D+ and UT89X (Abd El-Rhman's personal meter); add TDK-Lambda GEN300-11 and Long-Wei DC power supplies.
    - Inductor Classification: Replace all 'toroidal' mentions with 'E-core ferrite inductor' across modules 5 and 3.
    - Firmware Cle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
2026-11-05 Apply final OutJob name fix, telemetry header consolidation, and neutral BOM descriptions
    - Module 5: Update OutJob filename to 2q.OutJob in archive table and fabrication replication step.
    - Module 5 BOM: Neutralize descriptions for C5, C6, R1, and R2 with explicit '(see schematic)' references.
    - Firmware: Consolidate Bench_Telemetry_Sketch_2Q_PI header to single neutral source comment matching serial_monitor.jpg.
2026-11-05 Close solar-ev repository: integrate Central Boost schematics, neutralize BOM, and prune labels
    - Root README: Remove (STC) label from ASCII power balance block.
    - Module 1: Embed Central_Boost_MPPT_with_check Page1 and Page2 schematics in Global MPPT section and update image manifest.
    - Module 5 BOM: Neutralize resistor entries (R1, R2, R3/R5, R4/R6) to axial package without unverified wattage/film ratings.
    - Module 2: Rephrase ripple cancellation at D=0.5 to 'cancels (ideal case)'.
2026-11-06 Finalize Module 1 quickstart phrasing and prune unreferenced raw images
    - Module 1: Align Quickstart Step 4 with verified ~5.0 kW mean power settlement (4.8-5.2 kW ripple).
    - Module 1: Delete 6 unreferenced raw scope and legacy curve images from images/ directory to reduce repository footprint.
